han1079/Old-SSTC/Pictures and Documentation/Coil.JPG

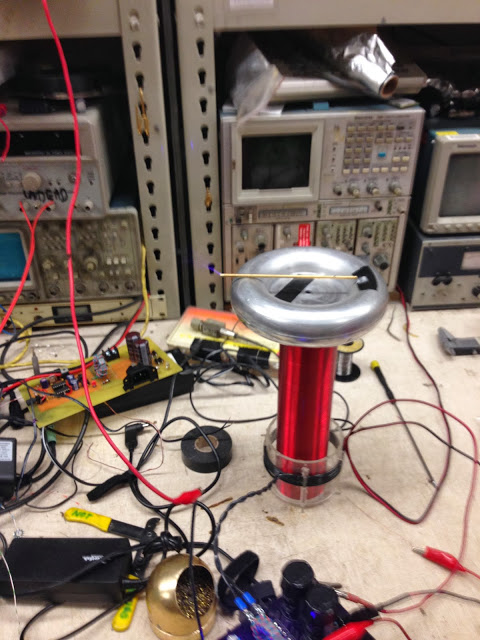
Pictures and Documentation/Coil.JPG
