han1079/Old-SSTC/Pictures and Documentation/PopulatedBoard.JPG

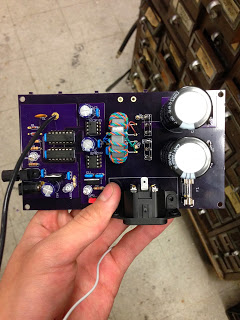
Pictures and Documentation/PopulatedBoard.JPG
