han1079/Old-SSTC/README.md

# Old-SSTC
Old Solid State Tesla Coil. Audio Modulated
