han1079/Old-SSTC/Pictures and Documentation/Solid State Tesla Coil Board.png

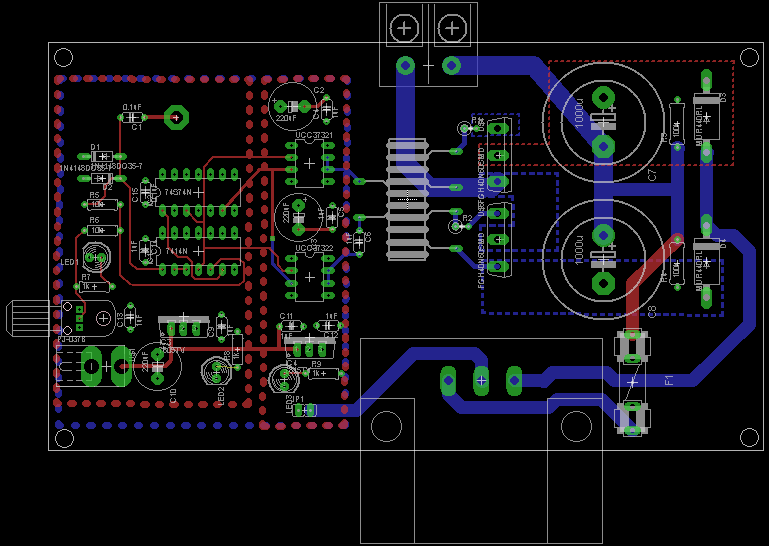
Pictures and Documentation/Solid State Tesla Coil Board.png
