han1079/Old-SSTC/Pictures and Documentation/Solid State Tesla Coil Schematic.png

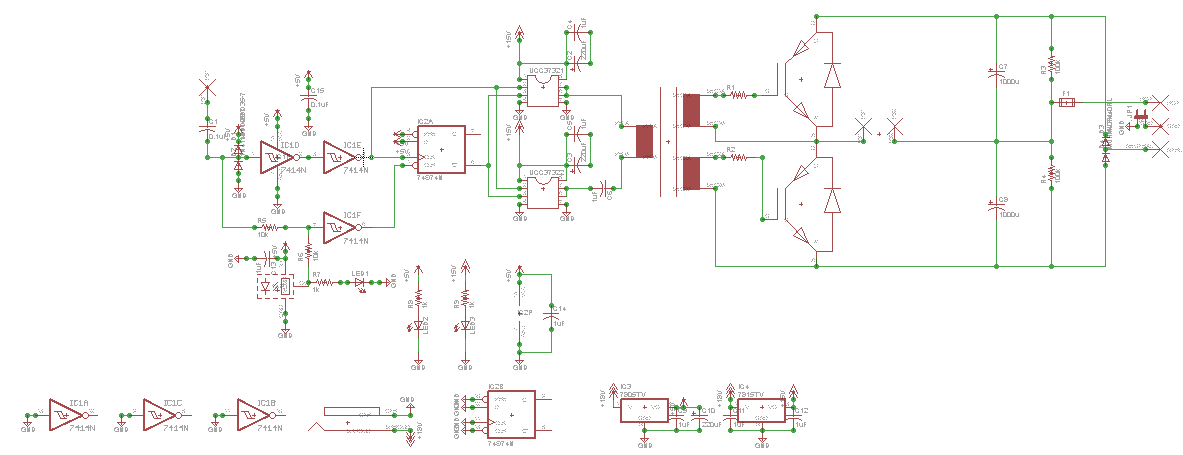
Pictures and Documentation/Solid State Tesla Coil Schematic.png
