han1079/Old-SSTC/Eagle Files/Tesla v0.1.brd

## EAGLE design Eagle Files/Tesla v0.1.brd (2017-01-16)

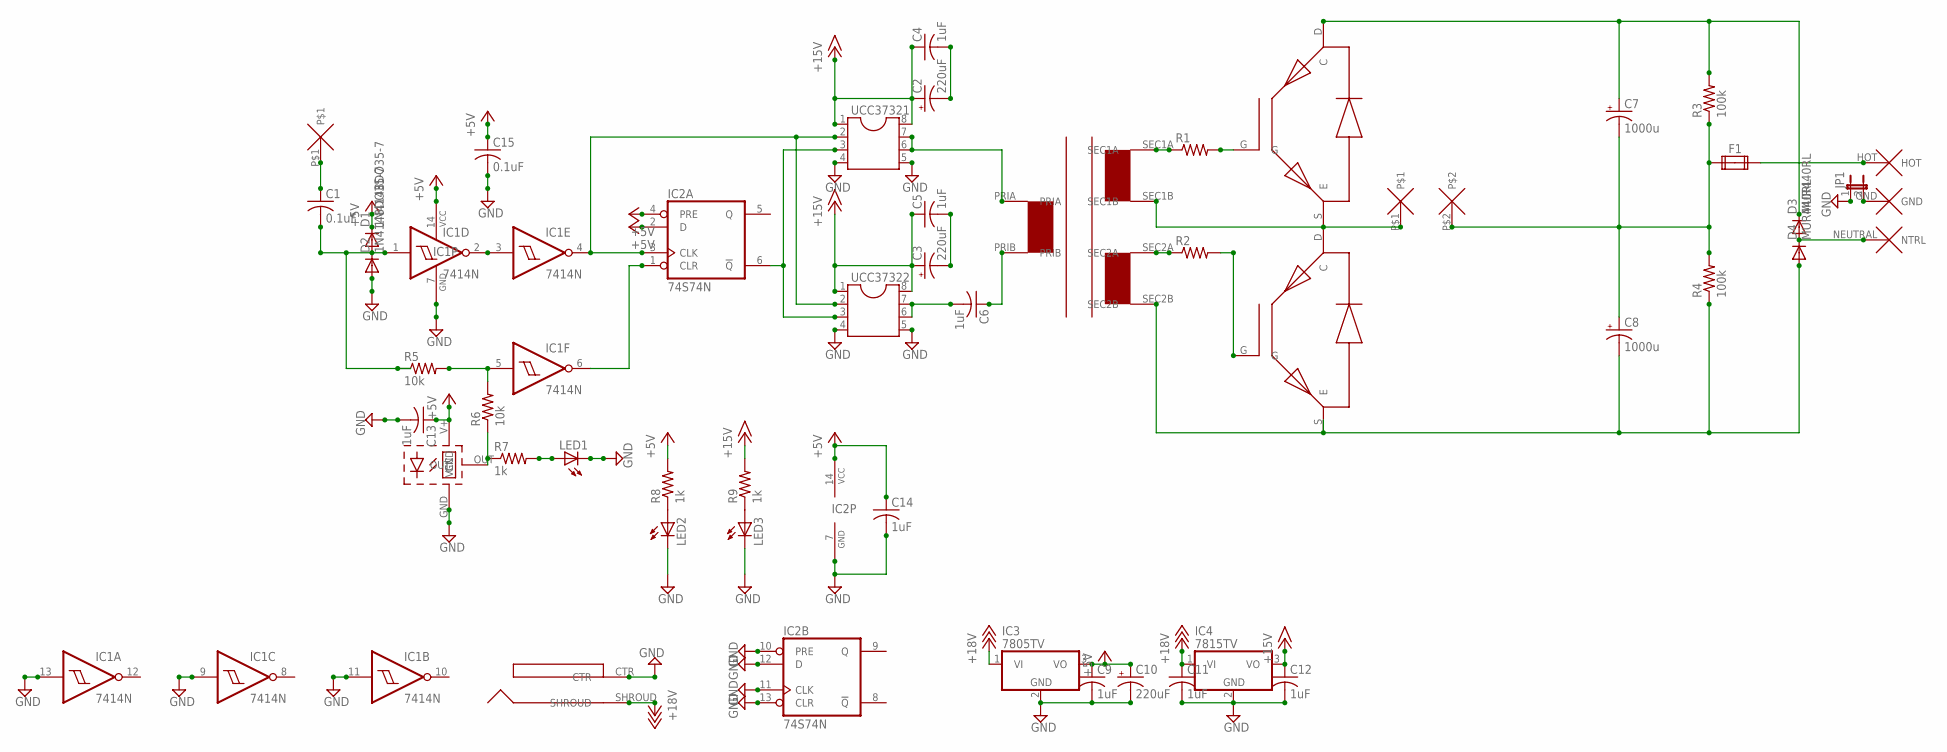
[picture p12: schematic Tesla v0.1.sch]

Parts:
C1, C15: 0.1uF; C050-024X044
C2, C3, C10: 220uF; E5-10,5
C4, C5, C6, C9, C11, C12, C13, C14: 1uF; C050-024X044
C7, C8: 1000u; EB25D
D1, D2: 1N4148DO35-7; DO35-7
D3, D4: MUR440RL; C2673
F1: FUSE2P; FUSE1
IC1: 7414N; DIL14
IC2: 74S74N; DIL14
IC3: 7805TV; TO220V
IC4: 7815TV; TO220V
JP1: JP1E; JP1
LED1, LED2, LED3: LED5MM
R1, R2: R-US_0309/V; 0309V
R3, R4: 100k; 0309/10
R5, R6: 10k; 0207/7
R7, R8, R9: 1k; 0207/7
U$1: PJ-037B; DJC0202
U$2: 12AWG_PAD
U$3: GDT
U$4, U$5: FGH40N60SMD; TO247BV
U$6: 2TERMINAL
U$7: IEC; IECPORT
U$8: IF-D95; IFD95
UCC37321, UCC37322: DIL8; DIL08

Connections:
+5V: C9.1, C10.+, C13.1, C14.1, C15.1, D1.C, IC1.14 (VCC), IC2.2 (D), IC2.4 (PRE), IC2.14 (VCC), IC3.3 (VO), R8.2, U$8.V+ (VCC)
+15V: C2.+, C3.+, C4.1, C5.1, C12.1, IC4.3 (VO), R9.2, UCC37321.1, UCC37321.8, UCC37322.1, UCC37322.8
+18V: C11.1, IC3.1 (VI), IC4.1 (VI), U$1.SHROUD
GND: C9.2, C10.-, C11.2, C12.2, C13.2, C14.2, C15.2, D2.A, IC1.7 (GND), IC1.9 (I), IC1.11 (I), IC1.13 (I), IC2.7 (GND), IC2.10 (PRE), IC2.11 (CLK), IC2.12 (D), IC2.13 (CLR), IC3.2 (GND), IC4.2 (GND), JP1.1, LED1.K (C), LED2.K (C), LED3.K (C), U$1.CTR, U$8.GND, UCC37321.4, UCC37321.5, UCC37322.4, UCC37322.5
unnamed: C1.1, U$2.P$1
unnamed: C1.2, D1.A, D2.C, IC1.1 (I), R5.1
unnamed: IC1.4 (O), IC2.3 (CLK), UCC37321.2, UCC37322.2
unnamed: IC1.6 (O), IC2.1 (CLR)
unnamed: IC2.6 (!Q), UCC37321.3, UCC37322.3
unnamed: C2.-, C4.2
unnamed: C3.-, C5.2
unnamed: U$3.PRIA, UCC37321.6, UCC37321.7
unnamed: C6.2, UCC37322.6, UCC37322.7
unnamed: C6.1, U$3.PRIB
unnamed: U$3.SEC1B, U$4.S (E), U$5.D (C), U$6.P$1
unnamed: R1.1, U$3.SEC1A
unnamed: R1.2, U$4.G
unnamed: R2.1, U$3.SEC2A
unnamed: R2.2, U$5.G
unnamed: IC1.5 (I), R5.2, R6.2
unnamed: R6.1, R7.1, U$8.OUT
unnamed: C7.-, C8.+, F1.1A, R3.1, R4.2, U$6.P$2
unnamed: D3.A, D4.C, U$7.NEUTRAL (NTRL)
unnamed: F1.2A, U$7.HOT
unnamed: JP1.2, U$7.GND
unnamed: LED1.A, R7.2
unnamed: LED2.A, R8.1
unnamed: LED3.A, R9.1
unnamed: IC1.2 (O), IC1.3 (I)
V+: C7.+, D3.C, R3.2, U$4.D (C)
V-: C8.-, D4.A, R4.1, U$3.SEC2B, U$5.S (E)

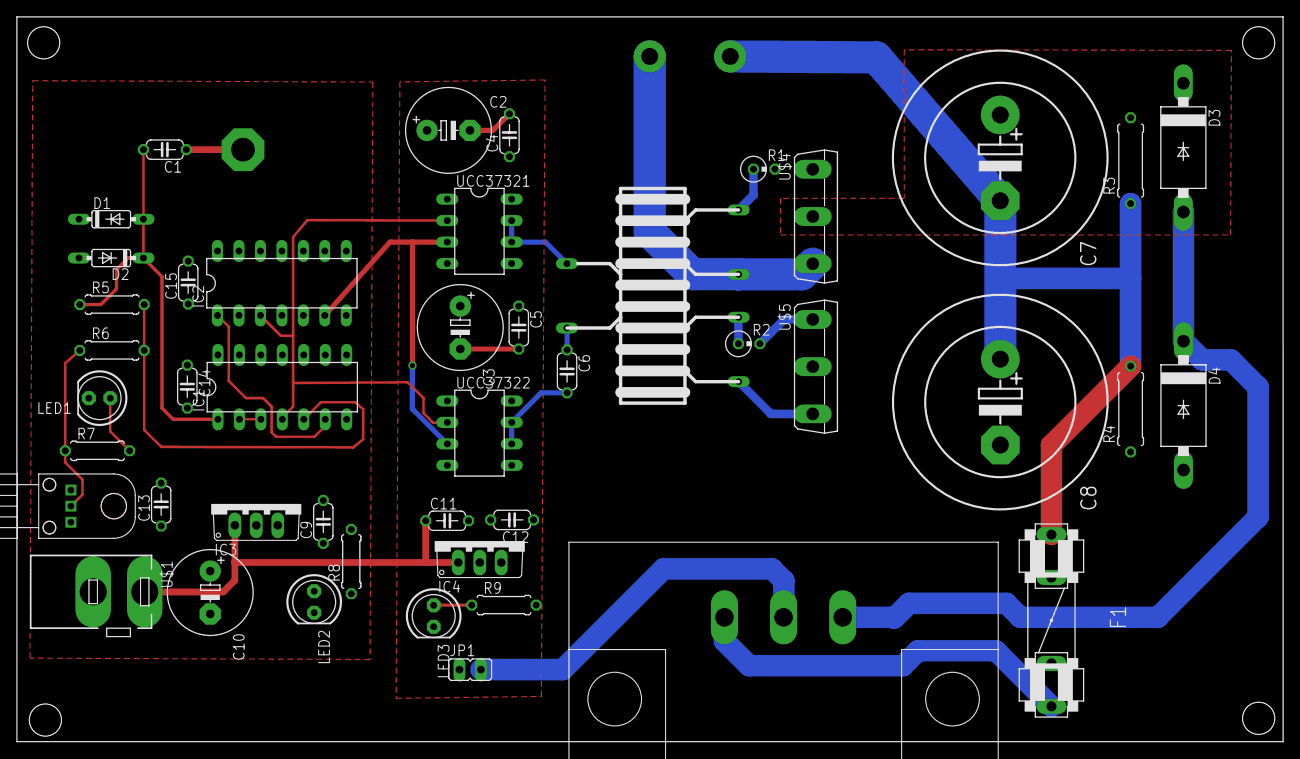
[picture p13: board Tesla v0.1.brd from above]

Board: 2 copper layers, 149.9 x 85.8 mm, 47 parts (1 on the bottom side), 31 nets.
